DMASHINO/WVR-turnout-decoder/20201027_170048.jpg

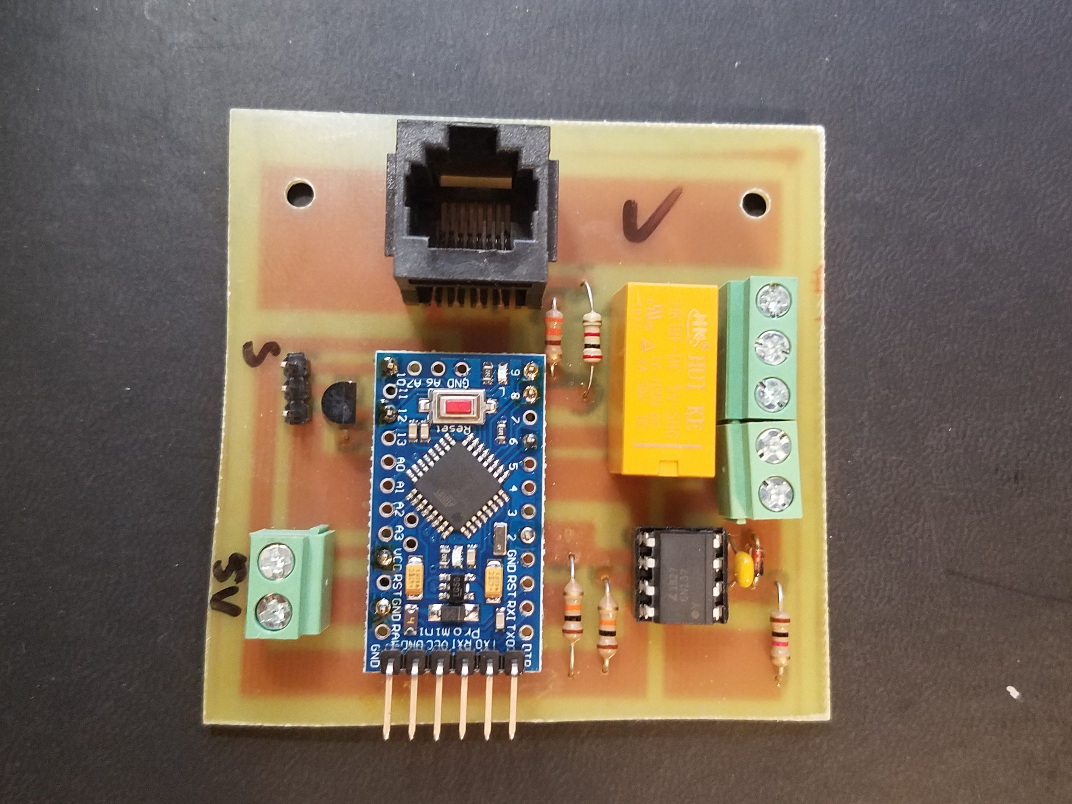
20201027_170048.jpg
