DMASHINO/WVR-turnout-decoder/README.md

# WVR-turnout-decoder
DCC turnout decoder for model railroading
Includes an arduino sketch, artwork for circuit board, 
supporting information on materials required, and 
picture of the finished board
