DMASHINO/WVR-turnout-decoder/acc decoder.jpg

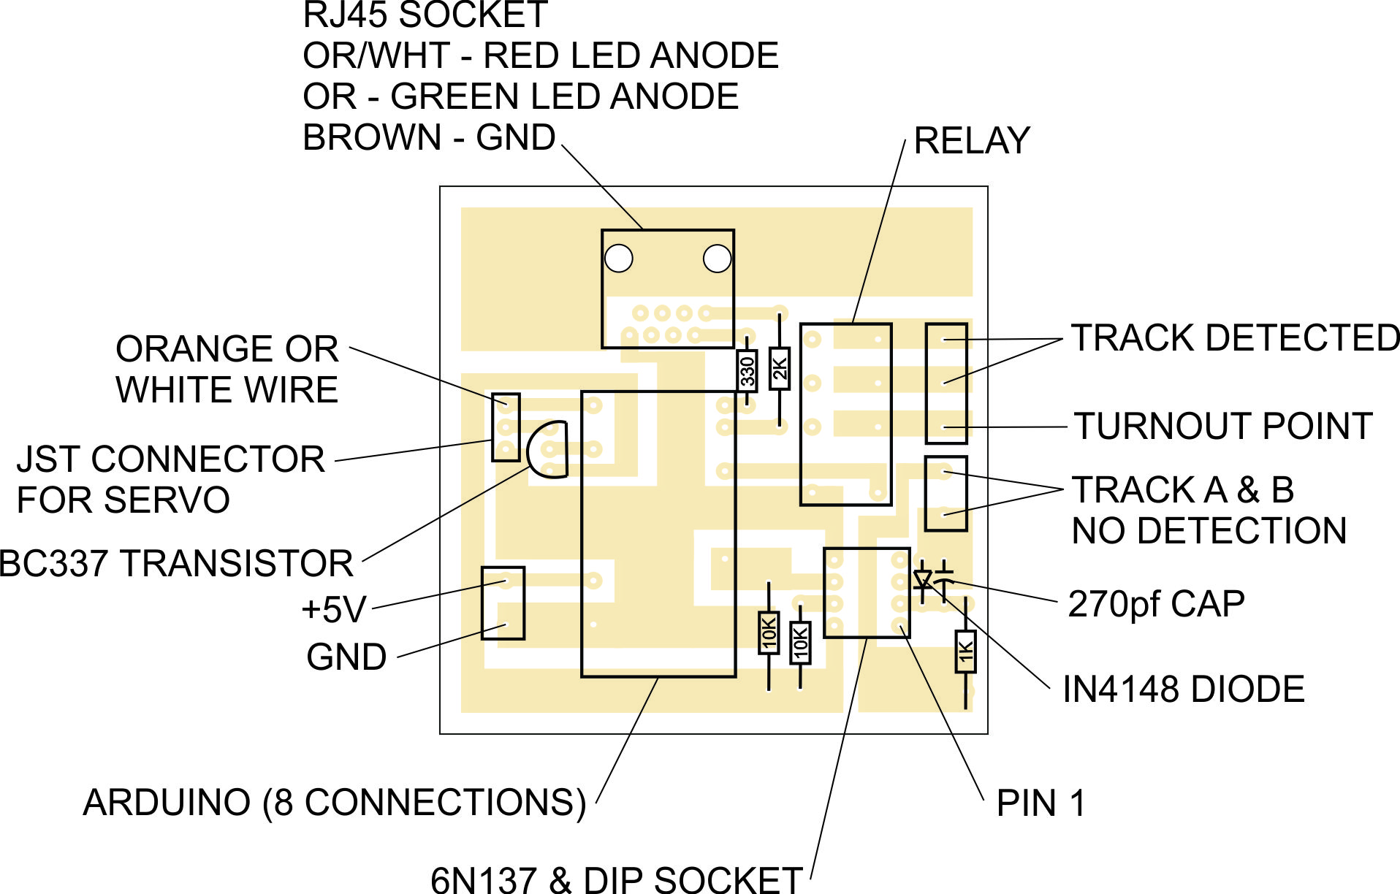
acc decoder.jpg
