DMASHINO/WVR-turnout-decoder/Parts and sources.xls

Programming Adaptor - buy one time
 | SparkFun FTDI Basic Breakout - 5V | $12.71 | https://www.amazon.com/SparkFun-FTDI-Basic-Breakout-5V/dp/B0068QKQEA
 | USB A male to Mini B male cable | $4.99 | https://www.amazon.com/Monoprice-15-Feet-Mini-B-Ferrite-105450/dp/B002KL8N6A
Etching Supplies - Enough to make many circuit boards
 | Positive Developer | $15.63 | https://www.amazon.com/MG-Chemicals-Positive-Developer-Bottle/dp/B005T8QLCY
 | Ferric Chloride Etching Solution | $22.83 | https://www.amazon.com/MG-Chemicals-Chloride-Etchant-Solution/dp/B005T8Y20W
Makes about 12 circuit boards
 | 8 x 12 Pre-sensitized circuit board | $19.00 | https://www.amazon.com/MG-Chemicals-630-Positive-Presensitized/dp/B008OAFQ8E
Components for each decoder
 | Circuit Board - 2-1/2 x 2-1/2 | $1.60 | From above
 | Arduino 5V pro-mini board | $2.36 | https://www.ebay.com/itm/Pro-Mini-ATMEGA328P-5V-16MHz-3-3V-8MHz-Compatible-to-Arduino-PRO-mini/253135496642
 | 6N137 Opto-Isolator IC | $0.80 | https://www.digikey.com/en/products/detail/lite-on-inc/6N137/1969175
 | DIP Socket | $0.18 | https://www.digikey.com/en/products/detail/assmann-wsw-components/A-08-LC-TT/821740
 | 5V relay | $0.98 | https://www.digikey.com/en/products/detail/cit-relay-and-switch/J104D2C5VDC-20S/12503179
 | RJ45 connector | $0.62 | https://www.digikey.com/en/products/detail/amphenol-icc-fci/54602-908LF/1001360
 | BC337 Transistor | $0.17 | https://www.digikey.com/en/products/detail/nte-electronics-inc/BC337/11652222
 | 1N4148 Diode | $0.10 | https://www.digikey.com/en/products/detail/on-semiconductor/1N4148/458603
 | 10K Ohm resistor | $0.03 | https://www.digikey.com/en/products/detail/stackpole-electronics-inc/CF14JT10K0/1741265
 | 1K Ohm resistor | $0.03 | https://www.digikey.com/en/products/detail/stackpole-electronics-inc/CF14JT1K00/1741314
 | 330 Ohm Resistor | $0.03 | https://www.digikey.com/en/products/detail/stackpole-electronics-inc/CF14JT330R/1741399
 | 2K Ohm Resistor | $0.03 | https://www.digikey.com/en/products/detail/stackpole-electronics-inc/CF14JT2K00/1741368
 | 2 Way Terminal | $0.03 | https://www.amazon.com/massmall-30Pieces-Pitch-Terminal-Connector/dp/B00XTXZLNQ
 | 3 Way Terminal | $0.35 | https://www.amazon.com/gp/product/B07VHFMTRP/ref=ppx_yo_dt_b_asin_title_o01_s01?ie=UTF8&psc=1
 | 270 pf Capacitor 50 V | $0.12 | https://www.digikey.com/en/products/detail/vishay-beyschlag-draloric-bc-components/K271J15C0GF5TL2/286472
Turnout Actuator
 | 9G hobby servo | $1.87 | https://www.amazon.com/gp/product/B072V529YD/ref=ppx_yo_dt_b_asin_title_o05_s00?ie=UTF8&psc=1
 | 1/2" Channel (inside dimension) | $0.50 | Hardware store, Menards, Lowes
 | 1/2" double backed mounting tape | $0.10 | https://www.amazon.com/gp/product/B00SJ6HA7S/ref=ppx_yo_dt_b_asin_title_o03_s00?ie=UTF8&psc=1
 | .039" Music wire | $0.10
Total cost |  | $10.00
