DMASHINO/WVR-turnout-decoder/turnout-cb_REVA.pdf

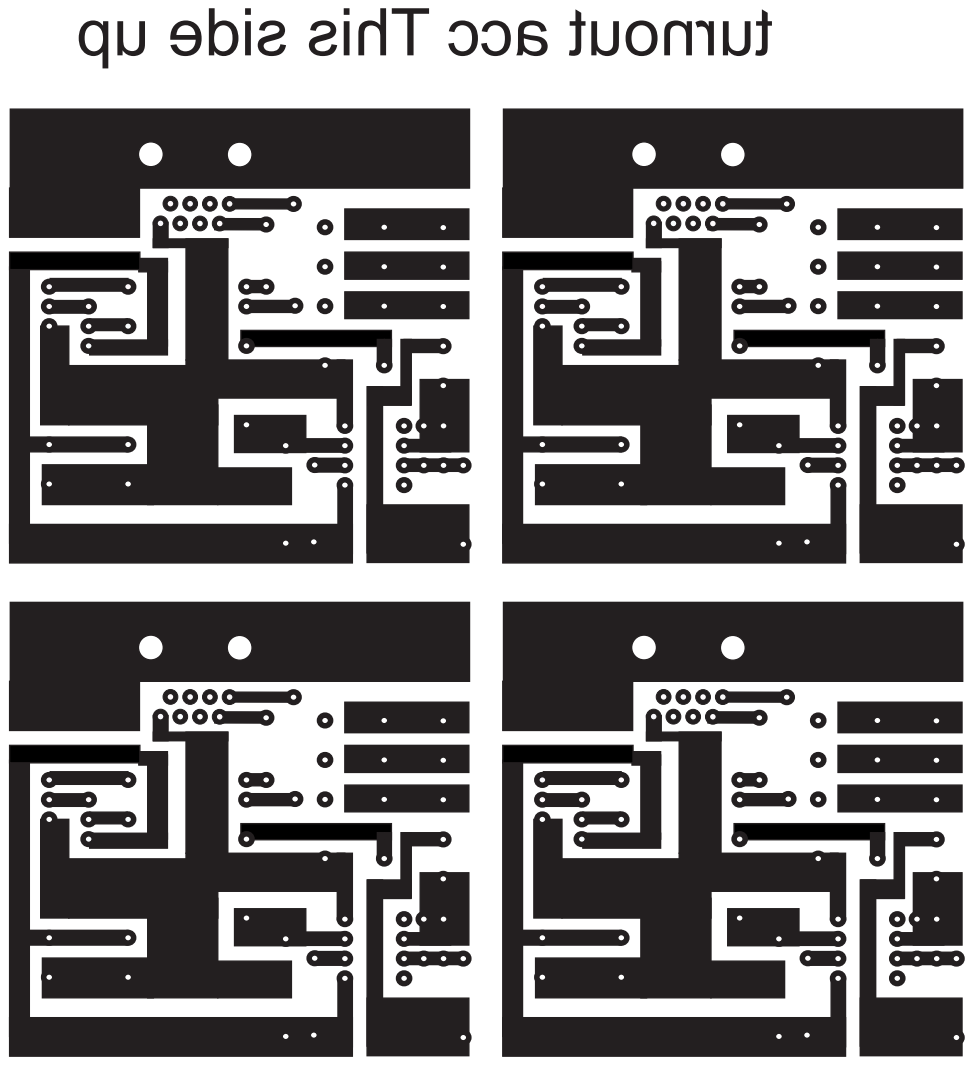
[picture p3: page 1]

This side up turnout acc
