DMASHINO/WVR-turnout-decoder/(commit log)

2020-11-17 DCC Turnout Decoder
    Arduino sketch and supporting files to build a decoder to operate a servo that throws a model railroad switch.
    [Parts and sources.xls]
2020-11-17 Create turnout001.ino
    Arduino Sketch
